clxjaguar/minitel5/doc/smartphone_to_minitel5_radiocom2000interface.png

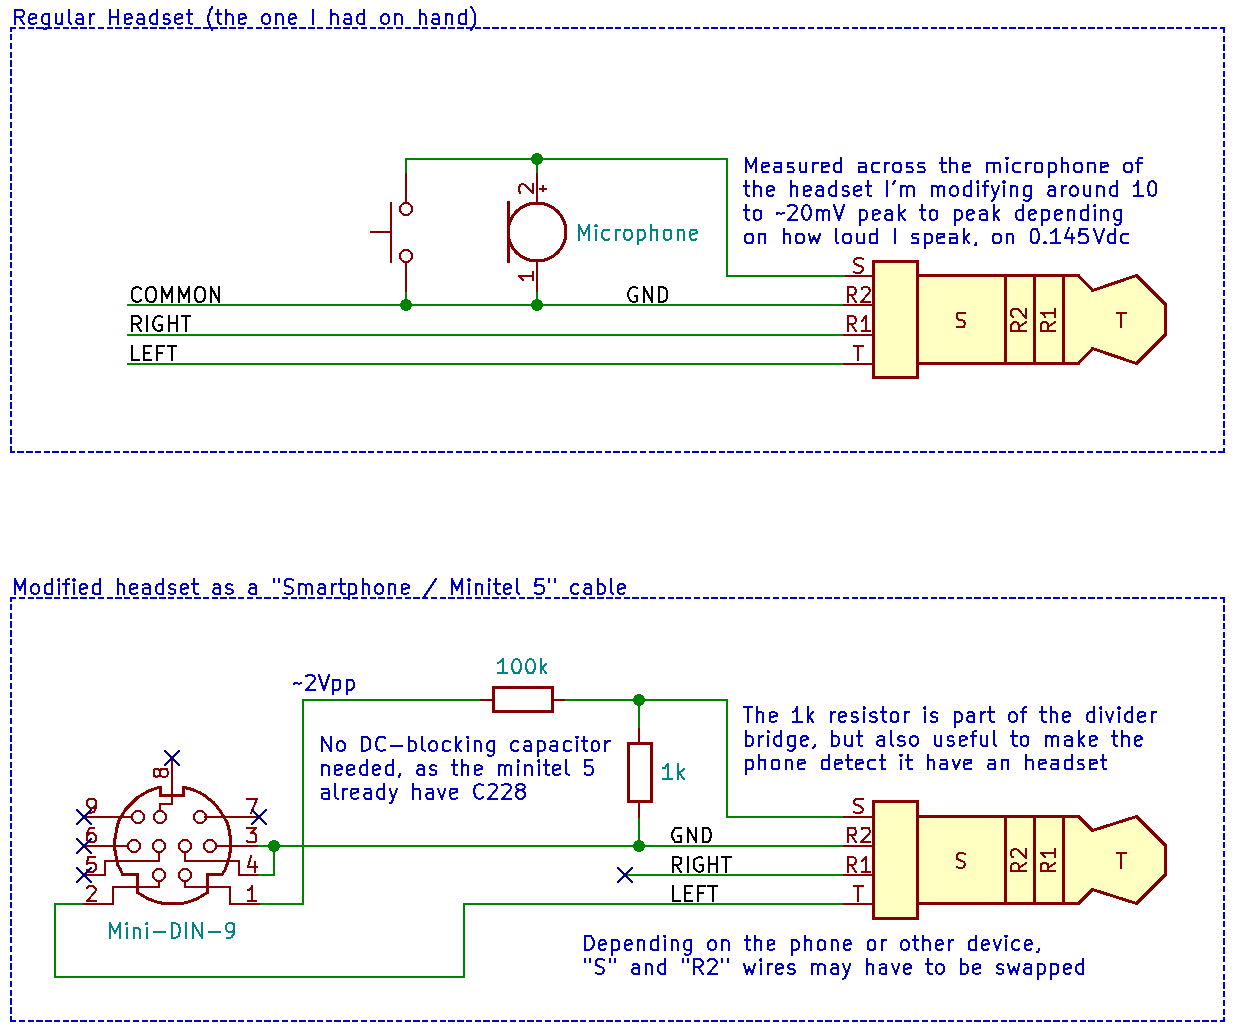
doc/smartphone_to_minitel5_radiocom2000interface.png
