clxjaguar/minitel5/dumps/Model AB1/HX0142AB1 GENE M5 1203 (all).png

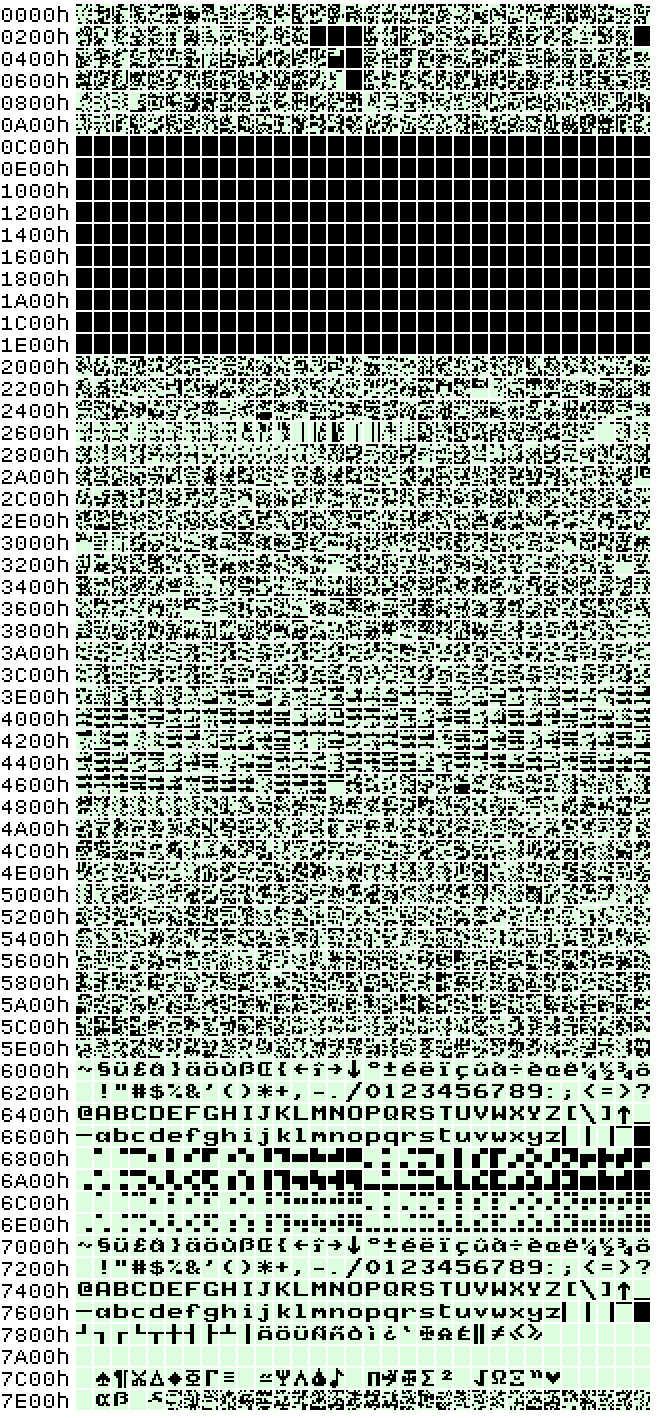
dumps/Model AB1/HX0142AB1 GENE M5 1203 (all).png
