clxjaguar/minitel5/kicad/output/minitel5.png

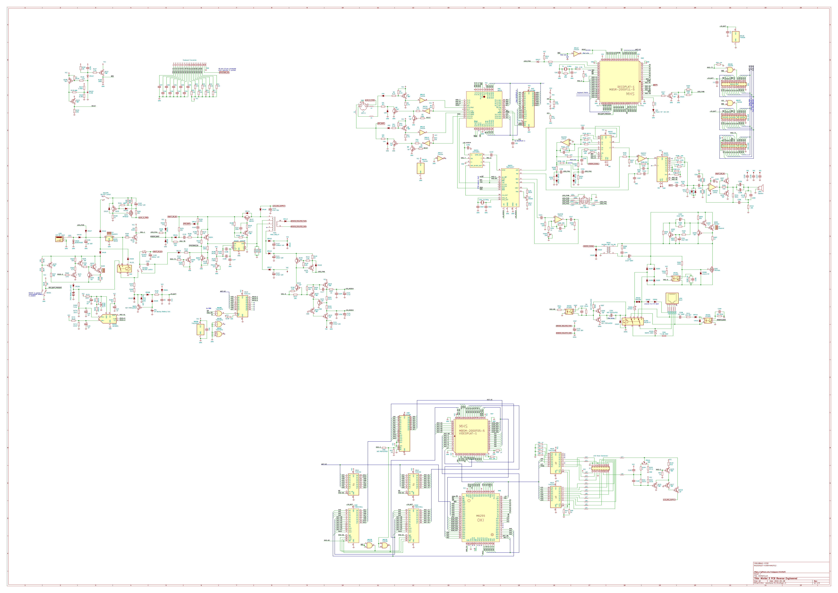
kicad/output/minitel5.png
