clxjaguar/minitel5/doc/smartphone_to_minitel5_radiocom2000interface.sch

## KiCad design doc/smartphone_to_minitel5_radiocom2000interface.sch (2022-12-02)

Schematic: smartphone_to_minitel5_radiocom2000interface.sch

Parts:
J1, J3: AudioPlug4
J2: Mini-DIN-9
MK1: Microphone
R1: 100k
R2: 1k
SW1: SW_Push

Notes on the sheet:
Measured across the microphone of the headset I'm modifying around 10 to ~~20mV peak to peak depending on how loud I speak, on 0.145Vdc
The 1k resistor is part of the divider bridge, but also useful to make the phone detect it have an headset
~~2Vpp
No DC-blocking capacitor needed, as the minitel 5 already have C228
Depending on the phone or other device, "S" and "R2" wires may have to be swapped
Regular Headset (the one I had on hand)
Modified headset as a "Smartphone / Minitel 5" cable
