clxjaguar/minitel5/kicad/minitel5.sch

## KiCad design kicad/minitel5.sch (2022-05-21)

Schematic: minitel5.sch

Parts:
BATTERY2: NiCd Battery (4 cells)
BT1: 3V Backup Battery Cell
C4, C9, C10, C13, C17, C18, C26, C27, C28, C29, C30, C31, C32, C33, C34, C35, C40, C103, C104, C106, C107, C108, C116, C117, C118, C119, C126, C204, C205, C206, C207, C209, C210, C211, C212, C213, C214, C215, C216, C217, C218, C219, C220, C221, C223, C224, C225, C226, C227, C228, C229, C230, C231, C232, C233, C236, C237: C
C101: 1uF 63V
C102, C112: 470uF 10V
C109, C113: 1000uF 10V
C110, C201: 10uF 50V
C111: 330n
C114: 220uF 10V
C115: 47uF 50V
C120, C121: 4.7uF
C122, C123, C124, C125: CP
C202: 2.2uF 63V
C203: 2.2uF 160V
C208: 1uF 160V
C234: NOT POPULATED
C235, C238: CP1_Small
CR1: \"Power On\" red LED
CR2, CR3, CR4, CR5, CR102, CR103, CR104, CR105, CR107, CR108, CR109, CR110, CR111, CR113, CR114, CR115, CR116, CR117, CR118, CR120, CR121, CR125, CR126, CR127, CR203, CR204, CR205, CR206, CR207, CR209, CR210, CR213, CR214, CR215, CR216, CR217, CR218, CR219, CR220, CR226: D_ALT
CR101: BZW04P100; D_DO-201AE_P15.24mm_Horizontal
CR106, CR119, CR123, CR201, CR202, CR212: D_Zener_ALT
CR112, CR221, CR227: D
CR122: NOT POPULATED
CR208: around 6V
E1, E2: Heatsink
F201: T 2.5A 250V
HS2: Heatsink
J1: DIN-5
J2: LCD Panel Connector
J101: 12V DC Input
J201: RJ12
J202: Mini-DIN-9
J203: Speaker
J999: Keyboard Connector
L1, L2, L3, L04, L05, L06, L07, L08, L09, L10, L11, L12, L13, L14, L15, L16, L17, L18, L101, L201, L202, L203, L204, L205, L206, L207, L208, L209, L210, L211, L212: L
MA101: 78M08; TO-220-3_Vertical
MA102: TL431; SOIC-8_3.9x4.9mm_P1.27mm
MA103: LM3578
MA104: ADC0831
MA105: LM385; SOIC-8_3.9x4.9mm_P1.27mm
MA201, MA202, MA203: H11AG2
MN1: 80C32
MN2: DECOPLAT
MN3, MN8: 27C256; DIP-28_W15.24mm
MN4: Backup RAM
MN5-RAM: Extension connector, RAM position
MN5-ROM: Extension connector, ROM position
MN6: MSM6255
MN7: VIDEOPLAT
MN9, MN10: FCB61C65LL
MN11, MN12, MN15, MN16: 74HC245
MN13: 74HC00
MN14: 74HC04
MN18: 74HC4075
MN19: 74HC273
MN201: TSB7513CP
MN202: 74HC4053
MN203: 27M4C
MN204: EFG71891
MN205: HC4052
PR101: 10k
PR102: 2k?
PR202: TPA130A
PR203: 4k?
PR204: 220
Q2, Q3, Q4, Q5, Q105, Q106, Q116, Q118, Q120, Q131, Q132, Q134, Q136, Q211: \"1B\"; SOT-23
Q6, Q7, Q108, Q110, Q112, Q114, Q115, Q117, Q119, Q121, Q122, Q123, Q124, Q125, Q126, Q130, Q135: \"3B\"; SOT-23
Q101: IRF9Z10; TO-220-3_Vertical
Q102, Q104: BC856; SOT-23
Q103, Q209: NOT POPULATED; SOT-23
Q113: BD132; TO-126-3_Vertical
Q133: Q_NPN_BCE
Q201: VN2410L; TO-92_Inline
Q202, Q203, Q206, Q207: \"6B\"; SOT-23
Q204: \"1V\"; SOT-23
Q205: BD232T; TO-126-3_Vertical
Q208: \"5B\"; SOT-23
R1, R15, R24, R29, R30, R31, R35, R36, R37, R39, R102, R120, R138, R234: 1k
R2, R4, R13, R16, R17, R18, R19, R20, R21, R22, R23, R25, R33, R101, R112, R126, R129, R147, R148, R155, R161, R163, R164, R176, R178, R179, R212, R226, R227, R231, R232, R247, R249, R257: 10k
R3, R6, R111, R113, R114, R115, R125, R128, R130, R132, R160, R204: 100k
R5, R9, R12, R14, R103, R165, R241: 4.7k
R7, R10, R118, R127, R230: 2.2k
R8, R11, R177, R210, R237: 8.2k
R26, R41: 470k
R32, R209, R213, R216: 1M
R38, R245: NOT POPULATED
R40: 1.5k
R104: 18k
R105, R106: 1
R108, R109, R173: 5.1k
R110, R203, R205, R215, R243, R254: 47k
R116: 6.19k
R117: 3.75k?
R119, R233: 68k
R131, R242: 22k
R134: 7.50k
R136: 38.3k
R137: 220k
R139: 330
R140: 4.7
R141, R142: 0.1
R143, R157, R168: 10
R144, R217, R218: 3.3k
R145: 6.8k
R146: 3.6k
R149, R225: 9.1k
R150: 9.8k
R151: 36.5k
R152, R171: 10.0k
R153: 45.3k
R154: 46.4k
R156: 22.1k
R158: 0
R162: 2.7k
R166: 1R8
R167: 390
R169: 71.5k
R170: 221k
R172: 56.2k
R174: 280.0k
R175: 100.0k
R201: 620k
R202: 82k
R206, R238, R255: 15k
R207: 12
R208, R248, R256: 560
R211: 13k
R214: 10k 3W?
R219, R224, R235, R239: 470
R220: 60.4k
R221, R223: 140k
R222: 211k
R228: 51k
R229: 620
R236: 3.9k
R240: 75k
R244: 820k
R246: N/P
R250, R251: 220
R252: 330k
R253: 150k
R258: 11k
RL101: V23026-A1001-B201 5V
RL201: RA12W-K
RV101, RV201: Varistor
ST1, ST2: TestPoint_2Pole
SW101: Pushed if rechargeable Battery is present
SW102: ON/OFF switch
T101: VOGT_406_47
TR201: PN230A ABC-24-90
VR1, VR2: TPJ
VR202: 593PH 230V
Y1: 11MHz
Y201: 3.57MHz

Connections:
6255_RD0: MN6.53 (RD0), MN7.37
6255_RD1: MN6.54 (RD1), MN7.38
6255_RD2: MN6.55 (RD2), MN7.39
6255_RD3: MN6.56 (RD3), MN7.40
6255_RD4: MN6.57 (RD4), MN7.41
6255_RD5: MN6.58 (RD5), MN7.42
6255_RD6: MN6.59 (RD6), MN7.45
6255_RD7: MN6.60 (RD7), MN7.46
+3V_BATT: C4.1, C9.1, C10.1, C13.1, CR104.1 (K), MN4.28, MN5-RAM.28, MN9.28 (VDD), MN10.28 (VDD), MN13.14 (VCC), R103.1
+5V_MODEM: C121.1, C229.1, C230.2, MN201.4 (+5V), MN204.1 (V+), R157.1
-5V_MODEM: C120.2, C232.1, MN201.7 (-5V), Q120.3 (C), R153.1
A0: MN2.10, MN3.10 (A0), MN4.10, MN5-RAM.10, MN5-ROM.10, MN6.22 (A0)
A1: MN2.9, MN3.9 (A1), MN4.9, MN5-RAM.9, MN5-ROM.9, MN6.21 (A1), MN18.8
A2: MN2.8, MN3.8 (A2), MN4.8, MN5-RAM.8, MN5-ROM.8, MN6.20 (A2)
A3: MN2.7, MN3.7 (A3), MN4.7, MN5-RAM.7, MN5-ROM.7, MN6.19 (A3)
A4: MN2.6, MN3.6 (A4), MN4.6, MN5-RAM.6, MN5-ROM.6, MN6.18 (A4)
A5: MN2.5, MN3.5 (A5), MN4.5, MN5-RAM.5, MN5-ROM.5, MN6.17 (A5)
A6: MN2.4, MN3.4 (A6), MN4.4, MN5-RAM.4, MN5-ROM.4, MN6.16 (A6)
A7: MN2.3, MN3.3 (A7), MN4.3, MN5-RAM.3, MN5-ROM.3, MN6.15 (A7)
A8: MN1.24 (P2.0/A8), MN2.22, MN3.25 (A8), MN4.25, MN5-RAM.25, MN5-ROM.25, MN6.14 (A8)
A9: MN1.25 (P2.1/A9), MN2.23, MN3.24 (A9), MN4.24, MN5-RAM.24, MN5-ROM.24, MN6.13 (A9)
A10: MN1.26 (P2.2/A10), MN2.24, MN3.21 (A10), MN4.21, MN5-RAM.21, MN5-ROM.21, MN6.12 (A10)
A11: MN1.27 (P2.3/A11), MN2.25, MN3.23 (A11), MN4.23, MN5-RAM.23, MN5-ROM.23, MN6.11 (A11)
A12: MN1.28 (P2.4/A12), MN2.26, MN3.2 (A12), MN4.2, MN5-RAM.2, MN5-ROM.2, MN6.10 (A12)
A13: MN1.29 (P2.5/A13), MN2.27, MN3.26 (A13), MN4.26, MN5-RAM.26, MN5-ROM.26, R41.1
A14: MN1.30 (P2.6/A14), MN2.28, MN3.27 (A14), MN4.1, MN5-RAM.1, MN5-ROM.27
A15: MN1.31 (P2.7/A15), MN2.29, MN3.20 (~CE), MN13.9, R26.1, ST1.2, ST2.1
AD0: MN1.43 (P0.0/AD0), MN2.13, MN3.11 (D0), MN4.11, MN5-RAM.11, MN5-ROM.11, MN6.45 (DB0), MN11.9 (A7), MN12.9 (A7), MN19.3 (D0)
AD1: MN1.42 (P0.1/AD1), MN2.14, MN3.12 (D1), MN4.12, MN5-RAM.12, MN5-ROM.12, MN6.46 (DB1), MN11.8 (A6), MN12.8 (A6), MN19.4 (D1)
AD2: MN1.41 (P0.2/AD2), MN2.15, MN3.13 (D2), MN4.13, MN5-RAM.13, MN5-ROM.13, MN6.47 (DB2), MN11.7 (A5), MN12.7 (A5), MN19.7 (D2)
AD3: MN1.40 (P0.3/AD3), MN2.16, MN3.15 (D3), MN4.15, MN5-RAM.15, MN5-ROM.15, MN6.48 (DB3), MN11.6 (A4), MN12.6 (A4), MN19.8 (D3)
AD4: MN1.39 (P0.4/AD4), MN2.17, MN3.16 (D4), MN4.16, MN5-RAM.16, MN5-ROM.16, MN6.49 (DB4), MN11.5 (A3), MN12.5 (A3), MN19.13 (D4)
AD5: MN1.38 (P0.5/AD5), MN2.18, MN3.17 (D5), MN4.17, MN5-RAM.17, MN5-ROM.17, MN6.50 (DB5), MN11.4 (A2), MN12.4 (A2), MN19.14 (D5)
AD6: MN1.37 (P0.6/AD6), MN2.19, MN3.18 (D6), MN4.18, MN5-RAM.18, MN5-ROM.18, MN6.51 (DB6), MN11.3 (A1), MN12.3 (A1), MN19.17 (D6)
AD7: MN1.36 (P0.7/AD7), MN2.20, MN3.19 (D7), MN4.19, MN5-RAM.19, MN5-ROM.19, MN6.52 (DB7), MN11.2 (A0), MN12.2 (A0), MN19.18 (D7)
ALE: C26.1, MN1.33 (ALE), MN2.21
ALIM_J1_PIN5: J1.5, Q101.2 (D), R101.2
BEEP: C221.1, MN2.83
BUSY: MN6.38 (BUSY), MN7.14
CH_CLK: MN6.37 (CH_CLK), MN7.13
CLP: MN6.26 (CLP), MN16.12 (B6)
DIEN: MN2.67, MN6.39 (DIEN), MN7.12
FRMB: MN6.27 (FRMB), MN16.11 (B7)
FRP: MN6.23 (FRP), MN7.11, MN16.15 (B3)
GA0: MN7.21, MN8.10 (A0)
GA1: MN7.22, MN8.9 (A1)
GA2: MN7.23, MN8.8 (A2)
GA3: MN7.24, MN8.7 (A3)
GA4: MN7.55, MN8.6 (A4), MN9.11 (D0), MN11.11 (B7)
GA5: MN8.5 (A5), MN9.12 (D1), MN11.12 (B6)
GA6: MN7.56, MN8.4 (A6), MN9.13 (D2), MN11.13 (B5)
GA7: MN8.3 (A7), MN9.15 (D3), MN11.14 (B4)
GA8: MN8.25 (A8), MN9.16 (D4), MN11.15 (B3)
GA9: MN8.24 (A9), MN9.17 (D5), MN11.16 (B2)
GA10: MN8.21 (A10), MN9.18 (D6), MN11.17 (B1)
GA11: MN7.57, MN8.23 (A11), MN9.19 (D7), MN11.18 (B0)
GA12: MN7.16, MN8.2 (A12)
GND: BATTERY2.2 (-), BT1.2 (-), C4.2, C9.2, C10.2, C13.2, C17.2, C18.1, C26.2, C27.1, C28.1, C29.1, C30.1, C31.1, C32.1, C33.1, C34.1, C35.1, C40.1, C101.2, C107.2, C109.2, C112.2, C113.2, C114.2, C115.1, C120.1, C121.1, C121.2, C122.2, C123.2, C124.2, C125.2, C205.1, C209.2, C210.1, C211.1, C223.2, C224.1, C225.1, C226.1, C227.1, C229.2, C230.1, C232.2, C237.2, CR1.1 (K), CR3.2 (A), CR4.2 (A), CR101.2 (A2), CR119.2 (A), CR122.2 (A), CR123.2 (A), CR209.2 (A), CR216.1 (K), CR217.1 (K), CR218.2 (A), CR220.1 (K), CR221.2 (A), CR226.2 (A), J1.2, J2.2, J2.7, J2.8, J2.20, J101.2, J101.3, J202.3, J202.7, J203.1, J999.19, MA101.2 (GND), MA102.2 (A), MA102.3 (A), MA102.6 (A), MA102.7 (A), MA103.4 (GND), MA103.5 (E), MA104.4 (GND), MA105.4 (A), MA202.2, MA203.4, MN1.22 (VSS), MN2.11, MN2.33, MN2.53, MN2.75, MN3.14 (GND), MN4.14, MN5-RAM.14, MN5-ROM.14, MN6.67 (VSS), MN7.9, MN7.27, MN7.43, MN7.61, MN8.14 (GND), MN8.22 (~OE), MN9.14 (GND), MN10.14 (GND), MN11.10 (GND), MN12.10 (GND), MN13.7 (GND), MN14.7 (GND), MN14.13, MN15.10 (GND), MN16.10 (GND), MN18.3, MN18.4, MN18.5, MN18.7 (GND), MN18.11, MN18.12, MN18.13, MN19.10 (GND), MN201.3 (GNDD), MN201.10 (GNDA), MN202.8 (VSS), MN203.12 (+), MN204.3 (V-), MN205.8 (VSS), PR102.1, PR102.2, PR204.1, PR204.2, Q2.2 (E), Q3.2 (E), Q4.2 (E), Q5.2 (E), Q103.3 (C), Q105.2 (E), Q106.2 (E), Q117.1 (B), Q119.1 (B), Q121.3 (C), Q124.3 (C), Q134.2 (E), Q136.2 (E), Q208.3 (C), Q211.2 (E), R9.2, R12.1, R15.2, R24.1, R25.1, R26.2, R29.2, R30.2, R31.2, R35.2, R36.2, R37.2, R39.2, R41.2, R102.2, R113.1, R116.2, R125.2, R128.2, R132.1, R141.2, R142.2, R156.1, R170.1, R171.1, R175.2, R216.2, R217.1, R219.1, R227.2, R230.2, R231.1, R232.1, R235.2, R239.2, R241.2, R242.2, R246.1, R253.2, RL101.8, ST1.1, SW101.2 (B), TR201.2 (AB)
GND1: C110.2, CR207.2 (A), Q209.3 (C), RL201.12, T101.9
J202_PIN1: C228.2, L206.1
J202_PIN2: C216.2, L207.2
J202_PIN4: L208.2, R248.2
J202_PIN5: CR227.1 (K), L209.2
J202_PIN6: CR120.2 (A), L210.1, Q126.3 (C)
J202_PIN8: L211.2, R250.2, R251.2
J202_PIN9: CR127.2 (A), L212.2
LCD_NEG_SUPPLY: C115.2, CR118.2 (A), Q118.2 (E)
LD0: MN6.28 (LD0), MN15.18 (B0)
LD1: MN6.29 (LD1), MN15.17 (B1)
LD2: MN6.30 (LD2), MN15.16 (B2)
LD3: MN6.31 (LD3), MN15.15 (B3)
LIP: MN6.24 (LIP), MN7.8, MN16.14 (B4)
MA0: MN6.6 (MA0), MN9.10 (A0), MN10.10 (A0)
MA1: MN6.5 (MA1), MN9.9 (A1), MN10.9 (A1)
MA2: MN6.4 (MA2), MN9.8 (A2), MN10.8 (A2)
MA3: MN6.3 (MA3), MN9.7 (A3), MN10.7 (A3)
MA12: MN6.74 (MA12), MN9.2 (A12), MN10.2 (A12)
MC~BC: MN2.1, MN201.22 (MC/~BC)
MN1-3: MN1.3 (P1.1/T2EX), MN2.40, R2.1
MN1-4: MN1.4 (P1.2), Q136.3 (C), R161.1
MN1-5: MA201.2, MN1.5 (P1.3)
MN1-6: MN1.6 (P1.4), MN202.10 (B), MN204.H (7)
MN1-7: MN1.7 (P1.5), MN204.2 (ISA)
MN1-8: MN1.8 (P1.6), MN202.9 (C)
MN1-9: MN1.9 (P1.7), R146.2, R147.2
MN2-2: MN2.2, Q125.1 (B), R24.2, R38.2
MN2-41: C27.2, J999.1, MN2.41
MN2-42: C28.2, J999.2, MN2.42
MN2-43: C29.2, J999.3, MN2.43
MN2-44: C30.2, J999.4, MN2.44
MN2-45: C31.2, J999.5, MN2.45
MN2-46: C32.2, J999.6, MN2.46
MN2-47: C33.2, J999.7, MN2.47
MN2-48: C34.2, J999.8, MN2.48
MN2-49: C35.2, J999.9, MN2.49
MN2-50: J999.10, MN2.50, R23.2
MN2-51: J999.11, MN2.51, R22.2
MN2-52: J999.12, MN2.52, R21.2
MN2-55: J999.13, MN2.55, R20.2
MN2-56: J999.14, MN2.56, R19.2
MN2-57: J999.15, MN2.57, R18.2
MN2-58: J999.16, MN2.58, R17.2
MN2-59: J999.17, MN2.59, R16.2
MN2-61: MA104.6 (DOUT), MN2.61
MN2-62: MN2.62, MN9.22 (~OE), MN10.22 (~OE)
MN2-63: MN2.63, MN12.19 (CE)
MN2-64: MN2.64, MN10.27 (~WE)
MN2-65: MN2.65, MN11.19 (CE)
MN2-66: MN2.66, MN9.27 (~WE)
MN2-71: MN2.71, MN5-ROM.20
MN2-72: MN2.72, MN13.1, R25.2
MN2-73: MN2.73, R115.2
MN2-78: MN2.78, R257.2
MN2-80: MN2.80, R211.1
MN2-81: MN2.81, MN205.9 (B)
MN2-82: MN2.82, MN205.10 (A)
MN2-84: MN2.84, MN201.1 (TEST)
MN6-~CS: MN2.69, MN6.41 (~CS), MN18.2
MN6_CLK: MN2.70, MN6.65 (XT)
MN7-1: MN6.1 (MA5), MN7.1
MN7-2: MN6.80 (MA6), MN7.2
MN7-3: MN6.79 (MA7), MN7.3
MN7-4: MN6.78 (MA8), MN7.4
MN7-5: MN6.77 (MA9), MN7.5
MN7-6: MN6.76 (MA10), MN7.6
MN7-7: MN6.75 (MA11), MN7.7
MN7-15: MN2.68, MN7.15
MN7-47: MN7.47, MN10.11 (D0), MN12.11 (B7)
MN7-48: MN7.48, MN10.12 (D1), MN12.12 (B6)
MN7-49: MN7.49, MN10.13 (D2), MN12.13 (B5)
MN7-50: MN7.50, MN10.15 (D3), MN12.14 (B4)
MN7-51: MN7.51, MN10.16 (D4), MN12.15 (B3)
MN7-52: MN7.52, MN10.17 (D5), MN12.16 (B2)
MN7-53: MN7.53, MN10.18 (D6), MN12.17 (B1)
MN7-54: MN7.54, MN10.19 (D7), MN12.18 (B0)
MN7-58: MN7.58, MN9.6 (A4), MN10.6 (A4)
MN7-59: MN7.59, MN9.5 (A5), MN10.5 (A5)
MN7-62: MN7.62, MN9.4 (A6), MN10.4 (A6)
MN7-63: MN7.63, MN9.3 (A7), MN10.3 (A7)
MN7-64: MN7.64, MN9.25 (A8), MN10.25 (A8)
MN7-65: MN7.65, MN9.24 (A9), MN10.24 (A9)
MN7-66: MN7.66, MN9.21 (A10), MN10.21 (A10)
MN7-67: MN7.67, MN9.23 (A11), MN10.23 (A11)
MN7-68: MN6.2 (MA4), MN7.68
MN19-2: MA104.1 (CS), MN19.2 (Q0)
MN19-5: MA104.7 (CLK), MN19.5 (Q1)
MN19-6: MN19.6 (Q2), R162.1
MODEM_ISOLATED_PWR: C110.1, CR113.1 (K), MA202.5, Q206.3 (C)
MODEM_SIGNAL: C205.2, CR210.2 (A), R224.1, R226.1, TR201.1 (AA)
unnamed: BATTERY2.1 (+), CR126.1 (K), R169.2, RL101.1
unnamed: BT1.1 (+), CR109.2 (A), Q103.1 (B)
unnamed: C17.1, R32.1, R40.2, Y1.2
unnamed: C18.2, MN2.35, R32.2, Y1.1
unnamed: C101.1, CR102.2 (A), CR103.1 (K), CR106.1 (K), CR125.2 (A), CR127.1 (K), MA101.1 (VI)
unnamed: C102.1, CR107.1 (K), Q102.2 (E), R105.1, R106.1, SW102.5 (B)
unnamed: C102.2, CR105.1 (K), R101.1
unnamed: C103.1, RV101.1, SW102.2 (B)
unnamed: C103.2, CR110.2 (A), SW102.1 (A)
unnamed: C104.2, CR112.2 (A), R126.2, R127.1
unnamed: C106.1, C107.1, C108.2, MA103.3 (CAP)
unnamed: C106.2, MA103.1 (E-), R137.2
unnamed: C108.1, R134.1, R136.2, R137.1
unnamed: C111.1, Q113.3 (B), R140.2
unnamed: C111.2, Q114.1 (B), R138.2, R139.2
unnamed: C114.1, CR115.1 (K), Q115.2 (E), R143.1
unnamed: C116.1, C126.2, L16.2, R151.2, R158.1
unnamed: C116.2, Q121.1 (B), R151.1, R152.1
unnamed: C117.1, Q122.3 (C), R154.1, R157.2
unnamed: C117.2, Q122.1 (B), R148.1, R150.1
unnamed: C118.1, R129.2
unnamed: C118.2, CR111.2 (A), R130.1
unnamed: C119.1, R155.1
unnamed: C119.2, CR121.2 (A), R131.2
unnamed: C122.1, MA104.3 (VIN-), R171.2, R172.2
unnamed: C123.1, MA104.5 (VREF), MA105.8 (K), R173.1, R174.1
unnamed: C124.1, MA104.8 (VCC), R168.1
unnamed: C125.1, MA104.2 (VIN+), R169.1, R170.2
unnamed: C201.1, Q202.1 (B), R203.1, R204.1
unnamed: C201.2, Q201.3 (D), Q202.2 (E), Q203.2 (E), R204.2, R206.1, R207.2, R208.1, TR201.4 (SB)
unnamed: C202.1, Q203.3 (C), Q204.1 (B), R202.1, R203.2, R205.1
unnamed: C202.2, Q202.3 (C), R205.2, R206.2
unnamed: C203.1, CR203.1 (K), CR204.1 (K), Q204.3 (C), Q205.2 (C), R201.2, R202.2
unnamed: C203.2, C204.2, TR201.3 (SA)
unnamed: C204.1, R208.2
unnamed: C206.1, CR205.2 (A), CR206.2 (A), CR208.2 (A), MA201.4, Q201.1 (S), R209.1
unnamed: C206.2, MA201.6, R209.2
unnamed: C207.1, MA202.4, Q206.1 (B), Q209.1 (B), R213.1, R245.2
unnamed: C207.2, MA202.6, R213.2
unnamed: C208.1, R214.2
unnamed: C208.2, L201.1, RL201.9
unnamed: C209.1, MA203.6, R216.1
unnamed: C210.2, MN201.17 (XTAL_IN), Y201.1
unnamed: C211.2, MN201.16 (XTAL_OUT), Y201.2
unnamed: C212.1, R256.2
unnamed: C212.2, C215.1, MN203.8, MN205.13 (X), R228.1
unnamed: C213.1, MN201.6 (ATO)
unnamed: C213.2, MN202.14 (X)
unnamed: C214.1, MN203.5 (+), R231.2
unnamed: C214.2, MN201.5 (RFO)
unnamed: C215.2, MN203.9 (-), R228.2
unnamed: C216.1, CR215.1 (K), R230.1, R255.2
unnamed: C217.1, C218.2, MN203.7, R233.2
unnamed: C217.2, MN201.15 (RDI), R232.2
unnamed: C218.1, MN203.6 (-), R233.1, R234.2
unnamed: C219.1, MN201.8 (DTMF)
unnamed: C219.2, MN204.8 (DTMF_OUT)
unnamed: C220.1, MN203.3 (+), R252.2, R253.1
unnamed: C220.2, CR217.2 (A), CR218.1 (K), R236.1, R237.1, R238.1, R240.1, R241.1
unnamed: C221.2, R240.2
unnamed: C228.1, CR219.1 (K), R229.2, R246.2
unnamed: C231.1, MN203.14, R223.2, R224.2, R225.1, R229.1, R258.2
unnamed: C231.2, MN203.13 (-), R220.2, R221.2, R222.2, R223.1
unnamed: C233.1, C235.2, C238.2, J203.2, R243.1
unnamed: C233.2, C236.2, R242.1, R243.2
unnamed: C234.1, C234.2, CR207.1 (K), Q206.2 (E), Q209.2 (E), R245.1, RL201.1
unnamed: C235.1, C238.1, Q207.2 (E), Q208.2 (E), R244.2, R254.2
unnamed: C236.1, MN203.2 (-), R244.1
unnamed: C237.1, MN201.9 (RAI), R256.1
unnamed: CR1.2 (A), R1.2
unnamed: CR2.2 (A), R11.2
unnamed: CR3.1 (K), Q2.3 (C), VR1.1
unnamed: CR4.1 (K), Q4.3 (C), VR2.1
unnamed: CR5.1 (K), L1.2
unnamed: CR5.2 (A), R8.2
unnamed: CR101.1 (A1), CR103.2 (A), L101.2
unnamed: CR102.1 (K), SW102.6 (C)
unnamed: CR105.2 (A), Q102.1 (B), R104.2
unnamed: CR106.2 (A), RL101.3
unnamed: CR107.2 (A), Q101.1 (G), Q102.3 (C), R102.1
unnamed: CR108.1 (K), CR109.1 (K), R103.2
unnamed: CR108.2 (A), CR122.1 (K), CR123.1 (K), Q103.2 (E), R108.2
unnamed: CR110.1 (K), R111.2
unnamed: CR112.1 (K), MA102.1 (K), R118.2
unnamed: CR113.2 (A), T101.10
unnamed: CR114.2 (A), CR118.1 (K), Q113.2 (C), T101.1
unnamed: CR115.2 (A), CR116.2 (A), T101.5
unnamed: CR117.1 (K), T101.2
unnamed: CR120.1 (K), Q126.2 (E), R143.2, R144.2
unnamed: CR125.1 (K), Q130.2 (E), Q132.3 (C), Q133.2 (C), Q135.2 (E), R163.1, R176.1
unnamed: CR126.2 (A), Q131.2 (E), R166.1, R167.1
unnamed: CR201.1 (K), L203.1
unnamed: CR201.2 (A), CR202.2 (A)
unnamed: CR202.1 (K), CR203.2 (A), CR205.1 (K), PR202.2 (A2), RL201.8
unnamed: CR204.2 (A), CR206.1 (K), PR202.1 (A1), RV201.2
unnamed: CR208.1 (K), MA201.5, Q201.2 (G), R201.1
unnamed: CR209.1 (K), CR210.1 (K)
unnamed: CR212.1 (K), R214.1
unnamed: CR212.2 (A), CR213.1 (K), MA203.1
unnamed: CR213.2 (A), L202.1, MA203.2, RL201.4
unnamed: CR214.2 (A), R215.1
unnamed: CR215.2 (A), CR216.2 (A)
unnamed: CR219.2 (A), CR220.2 (A)
unnamed: CR221.1 (K), Q211.3 (C), R250.1, R251.1
unnamed: CR227.2 (A), R212.1, R249.2
unnamed: F201.1, L204.1
unnamed: F201.2, RL201.3, VR202.1
unnamed: J1.1, L1.1
unnamed: J1.3, L2.2
unnamed: J1.4, L3.1
unnamed: J2.1, L18.2
unnamed: J2.3, L13.2
unnamed: J2.4, L12.2
unnamed: J2.5, L15.2
unnamed: J2.6, L14.2
unnamed: J2.9, L07.2
unnamed: J2.10, L06.2
unnamed: J2.11, L05.2
unnamed: J2.12, L04.2
unnamed: J2.13, L16.1
unnamed: J2.14, L17.1
unnamed: J2.16, L11.2
unnamed: J2.17, L10.2
unnamed: J2.18, L09.2
unnamed: J2.19, L08.2
unnamed: J101.1, L101.1
unnamed: J201.1, L203.2
unnamed: J201.2, L201.2
unnamed: J201.3, L205.2
unnamed: J201.4, L204.2
unnamed: J201.5, L202.2
unnamed: J202.1, L206.2
unnamed: J202.2, L207.1
unnamed: J202.4, L208.1
unnamed: J202.5, L209.1
unnamed: J202.6, L210.2
unnamed: J202.8, L211.1
unnamed: J202.9, L212.1
unnamed: L2.1, VR1.2
unnamed: L04.1, MN15.9 (A7)
unnamed: L05.1, MN15.8 (A6)
unnamed: L06.1, MN15.7 (A5)
unnamed: L07.1, MN15.6 (A4)
unnamed: L08.1, MN15.5 (A3)
unnamed: L09.1, MN15.4 (A2)
unnamed: L10.1, MN15.3 (A1)
unnamed: L11.1, MN15.2 (A0)
unnamed: L12.1, MN16.9 (A7)
unnamed: L13.1, MN16.8 (A6)
unnamed: L14.1, MN16.6 (A4)
unnamed: L15.1, MN16.5 (A3)
unnamed: L17.2, PR101.2, Q118.3 (C)
unnamed: L205.1, RL201.10, VR202.2
unnamed: MA101.3 (VO), R160.2, RL101.10
unnamed: MA102.8 (REF), R116.1, R117.2, R119.1
unnamed: MA103.6 (C), Q114.3 (C), R139.1
unnamed: MA103.7 (ILIM), R141.1, R142.1, T101.3
unnamed: MA103.8 (VIN), Q104.3 (C), R114.2
unnamed: MA105.5 (FB), R174.2, R175.1
unnamed: MA201.1, R210.1
unnamed: MA202.1, R211.2
unnamed: MN1.11 (P3.0/RxD), MN14.8
unnamed: MN1.13 (P3.1/TxD), MN14.1, R4.1
unnamed: MN1.14 (P3.2/~INT0), MN14.4
unnamed: MN1.16 (P3.4/T0), MN14.5, R13.1
unnamed: MN2.34, R249.1
unnamed: MN2.76, R1.1
unnamed: MN2.77, R247.1
unnamed: MN7.25, R33.1
unnamed: MN7.28, R39.1
unnamed: MN9.20 (~CE1), MN10.20 (~CE1), MN13.6
unnamed: MN9.26 (CE2), MN10.26 (CE2), MN13.11
unnamed: MN4.20, MN13.3
unnamed: MN5-RAM.20, MN13.8
unnamed: MN8.20 (~CE), MN13.12, MN13.13, R37.1, R38.1
unnamed: MN14.2, R5.1
unnamed: MN14.3, Q6.3 (C), R12.2
unnamed: MN14.6, R14.2
unnamed: MN14.9, Q7.3 (C), R9.1
unnamed: MN2.30, MN14.10
unnamed: MN15.1 (A->B), MN16.1 (A->B), R35.1
unnamed: MN15.19 (CE), MN16.19 (CE), R15.1
unnamed: MN16.13 (B5), R36.1
unnamed: MN16.16 (B2), R29.1
unnamed: MN16.17 (B1), R30.1
unnamed: MN16.18 (B0), R31.1
unnamed: MN18.9, MN19.11 (Cp)
unnamed: MN19.1 (~Mr), R179.1
unnamed: MN201.11 (RSA), PR203.2
unnamed: MN201.12 (VREF), R218.2
unnamed: MN201.20 (CLK_OUT), MN204.4 (OSC_IN)
unnamed: MN202.1 (Y1), R221.1
unnamed: MN202.2 (Y0), R222.1
unnamed: MN202.3 (Z1), R226.2
unnamed: MN202.4 (Z), MN203.10 (+), R225.2, R227.1
unnamed: MN202.5 (Z0), R255.1, R258.1
unnamed: MN202.6 (Inh), R219.2
unnamed: MN202.12 (X0), MN202.15 (Y)
unnamed: MN202.13 (X1), R220.1
unnamed: MN203.1, Q207.1 (B), Q208.1 (B), R254.1
unnamed: MN205.1 (Y0), MN205.2 (Y2), MN205.4 (Y3), MN205.5 (Y1), R239.1
unnamed: MN205.6 (Inh), R235.1
unnamed: MN205.11 (X3), R236.2
unnamed: MN205.14 (X1), R238.2
unnamed: MN205.15 (X2), R237.2
unnamed: PR101.1, R156.2
unnamed: PR101.3, R158.2
unnamed: PR102.3, R134.2
unnamed: PR203.1, R218.1
unnamed: PR203.3, R217.2
unnamed: PR204.3, R234.1
unnamed: Q2.1 (B), Q3.3 (C), R5.2
unnamed: Q3.1 (B), R3.2
unnamed: Q4.1 (B), Q5.3 (C), R14.1
unnamed: Q5.1 (B), R6.1
unnamed: Q6.1 (B), R10.1, R11.1
unnamed: Q7.1 (B), R7.1, R8.1
unnamed: Q101.3 (S), R104.1, R105.2, R106.2
unnamed: Q104.1 (B), R110.1, R112.2, R129.1, R155.2
unnamed: Q105.1 (B), Q106.3 (C), R111.1, R113.2, R114.1
unnamed: Q106.1 (B), R115.1, R132.2
unnamed: Q108.1 (B), R118.1, R120.1
unnamed: Q108.3 (C), Q110.1 (B), R119.2
unnamed: Q112.1 (B), R127.2
unnamed: Q114.2 (E), R140.1
unnamed: Q115.1 (B), R144.1, R145.1
unnamed: Q115.3 (C), Q116.3 (C), Q126.1 (B), R145.2
unnamed: Q116.1 (B), Q123.1 (B), R147.1, R148.2
unnamed: Q116.2 (E), R146.1
unnamed: Q117.2 (E), Q121.2 (E), Q125.3 (C)
unnamed: Q117.3 (C), Q118.1 (B)
unnamed: Q119.2 (E), Q123.3 (C), Q124.2 (E)
unnamed: Q119.3 (C), Q120.1 (B)
unnamed: Q123.2 (E), R150.2
unnamed: Q124.1 (B), R153.2, R154.2
unnamed: Q125.2 (E), R149.1
unnamed: Q130.1 (B), R163.2, R165.1
unnamed: Q130.3 (C), R164.2
unnamed: Q131.1 (B), Q133.3 (E), R166.2
unnamed: Q131.3 (C), Q132.1 (B), R164.1
unnamed: Q132.2 (E), Q133.1 (B)
unnamed: Q134.1 (B), R162.2
unnamed: Q134.3 (C), R165.2
unnamed: Q135.1 (B), R176.2, R177.1
unnamed: Q135.3 (C), R167.2
unnamed: Q136.1 (B), R160.1
unnamed: Q203.1 (B), Q205.1 (E), R207.1
unnamed: Q204.2 (E), Q205.3 (B)
unnamed: Q211.1 (B), R247.2
unnamed: R108.1, R109.2
unnamed: R109.1, RL101.5, SW102.3 (C)
unnamed: R177.2, SW101.3 (C)
unnamed: RL201.5, RV201.1
OSC: MN1.21 (XTAL1), MN2.37
RA0: MN6.61 (RA0), MN7.17
RA1: MN6.62 (RA1), MN7.18
RA2: MN6.63 (RA2), MN7.19
RA3: MN6.64 (RA3), MN7.20
RESET: MN1.10 (RST), Q110.3 (C), R3.1, R6.2, R125.1
ROM: MN1.15 (P3.3/~INT1), MN201.13 (RXD)
TDM: MN1.17 (P3.5/T1), MN201.21 (TXD), MN204.6 (A)
UD0: MN6.33 (UD0), MN15.14 (B4)
UD1: MN6.34 (UD1), MN15.13 (B5)
UD2: MN6.35 (UD2), MN15.12 (B6)
UD3: MN6.36 (UD3), MN15.11 (B7)
VBATT_OR_8V: C109.1, CR114.1 (K), Q104.2 (E), Q113.1 (E), Q207.3 (C), R110.2, R130.2, R131.1, R138.1, RV101.2
VCC: C40.2, C104.1, C113.1, C126.1, C223.1, C224.2, CR104.2 (A), CR116.1 (K), CR119.1 (K), L18.1, MN1.44 (Vcc), MN2.12, MN2.32, MN2.54, MN2.74, MN3.1 (VPP), MN3.28 (VCC), MN5-ROM.1, MN5-ROM.28, MN6.32 (VDD), MN6.40 (~ADF), MN6.70 (~DIV), MN7.10, MN7.26, MN7.44, MN7.60, MN8.1 (VPP), MN8.26 (A13), MN8.27 (A14), MN8.28 (VCC), MN11.20 (VCC), MN12.20 (VCC), MN14.14 (VCC), MN15.20 (VCC), MN16.20 (VCC), MN18.14 (VCC), MN19.20 (VCC), MN202.16 (VDD), MN203.4 (V+), MN205.16 (VDD), Q6.2 (E), Q7.2 (E), Q108.2 (E), Q110.2 (E), Q112.2 (E), Q122.2 (E), R2.2, R4.2, R7.2, R10.2, R13.2, R16.1, R17.1, R18.1, R19.1, R20.1, R21.1, R22.1, R23.1, R33.2, R117.1, R120.2, R126.1, R136.1, R149.2, R152.2, R161.2, R168.2, R172.1, R173.2, R178.1, R179.2, R210.2, R212.2, R215.2, R252.1, ST2.2
VD0: MN7.29, MN8.11 (D0)
VD1: MN7.30, MN8.12 (D1)
VD2: MN7.31, MN8.13 (D2)
VD3: MN7.32, MN8.15 (D3)
VD4: MN7.33, MN8.16 (D4)
VD5: MN7.34, MN8.17 (D5)
VD6: MN7.35, MN8.18 (D6)
VD7: MN7.36, MN8.19 (D7)
VEE: C112.1, C121.2, C225.2, C226.2, C227.2, CR117.2 (A), MN202.7 (VEE), MN203.11 (V-), MN205.7 (VEE), Q120.2 (E)
~DCD: MN2.79, MN201.14 (~DCD)
~DIN_WAKE: CR2.1 (K), CR111.1 (K), L3.2, VR2.2
~MODEM_WAKE: CR121.1 (K), CR214.1 (K), CR226.1 (K), MA203.5, R248.1, R257.1
~PSEN: MN1.32 (~PSEN), MN3.22 (~OE), MN5-ROM.22
~RCH_BATT_PRESENT: MN2.60, R178.2, SW101.1 (A)
~RD: MN1.19 (P3.7/~RD), MN2.38, MN4.22, MN5-RAM.22, MN6.42 (~RD), MN11.1 (A->B), MN12.1 (A->B)
~RES: MN6.44 (~RES), MN13.2, MN13.4, MN13.5, MN13.10, MN14.11, Q112.3 (C), R128.1
~RTS: MN1.2 (P1.0/T2), MN201.2 (~RTS), MN202.11 (A)
~SPACEBAR_SW: J999.18, Q105.3 (C), R112.1
~WR: MN1.18 (P3.6/~WR), MN2.39, MN4.27, MN5-RAM.27, MN6.43 (~WR), MN18.1

Notes on the sheet:
from DECOPLAT-1
(PCB labeled vias)
to DECOPLAT-1
Mod wire
SW101 is pushed if rechargeable battery is present
18 and 19 are connected when spacebar is pushed
from DECOPLAT
CUT
Keyboard Matrix
from MN1 (80C32)
from MN1
to MN1
Mod strap
around 3 or 4V each
