clxjaguar/minitel5/(commit log)

2022-04-07 Added the board and its shematics reverse engineered (GIMP file archive is using git-lfs)
    [minitel5.sch]
2022-04-07 Updated README.md after PCB reverse-engineering update
2022-05-06 Updated Kicad schematics
    [minitel5.sch]
2022-05-08 Adding schematics exports to README.md
    [minitel5.sch]
2022-05-14 Correcting some typos and smalls things in schematics
    [minitel5.sch]
2022-05-19 Updated README.md and power.png
2022-05-21 Small schematic fix
    [minitel5.sch]
2022-06-11 Added what I wrote down about my tries with the Radiocom 2000 connector into README.md
2022-10-31 Added (with picture) comment about putting back MN8 on low profile sockets
2022-11-29 Added: smartphone to minitel5/radiocom2000 interface cable
    [smartphone_to_minitel5_radiocom2000interface.sch]
2022-12-02 Some documentation fix (mV->V and sym-lib-tables update)
    [smartphone_to_minitel5_radiocom2000interface.sch]
2022-12-25 Typo fix (LED panel -> LCD panel)
2023-06-26 Added: Schottky diode mod to deliver power on DIN connector when the minitel is running on its internal batteries
